Mister-Awsum/3D-Room-Scan/Project Info/20240410_174906.jpg

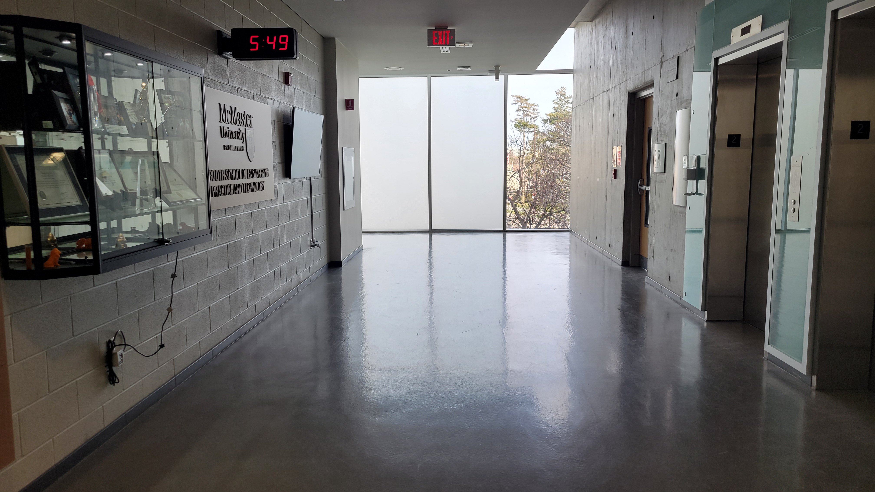
Project Info/20240410_174906.jpg
