Mister-Awsum/3D-Room-Scan/Data/2DX3 C Code Flowchart.png

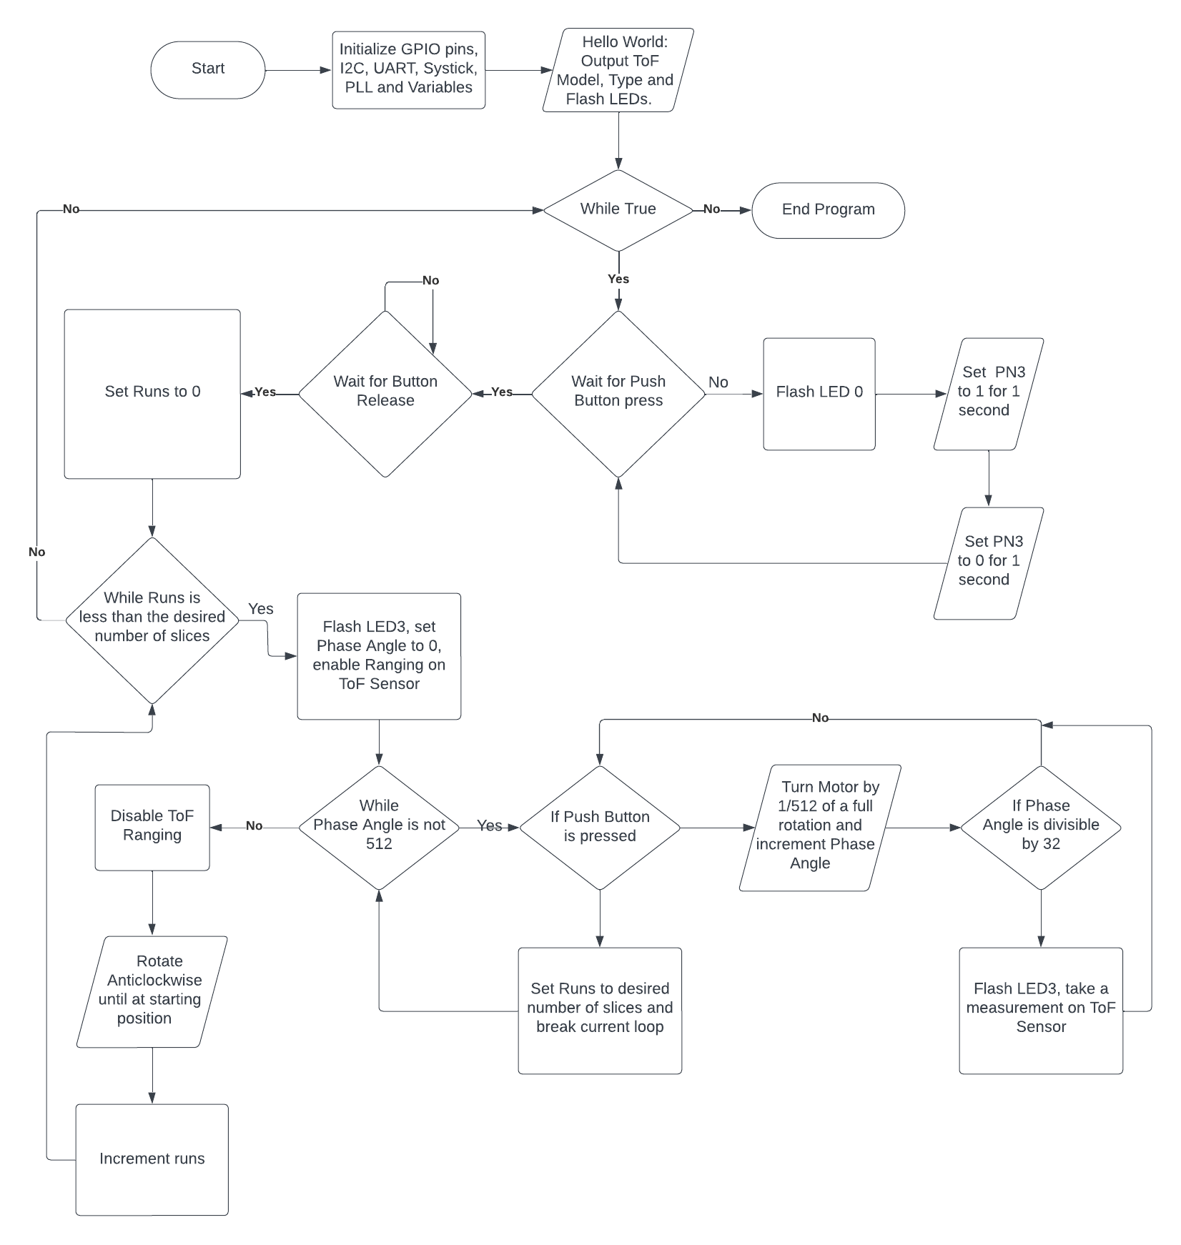
Data/2DX3 C Code Flowchart.png
