Mister-Awsum/3D-Room-Scan/Data/2DX3 Project Circuit Schematic.png

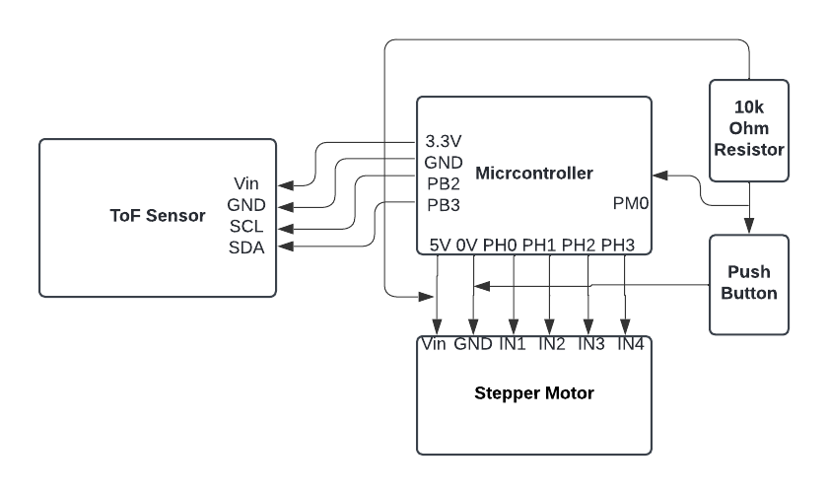
Data/2DX3 Project Circuit Schematic.png
