Mister-Awsum/3D-Room-Scan/Data/Also Scan.png

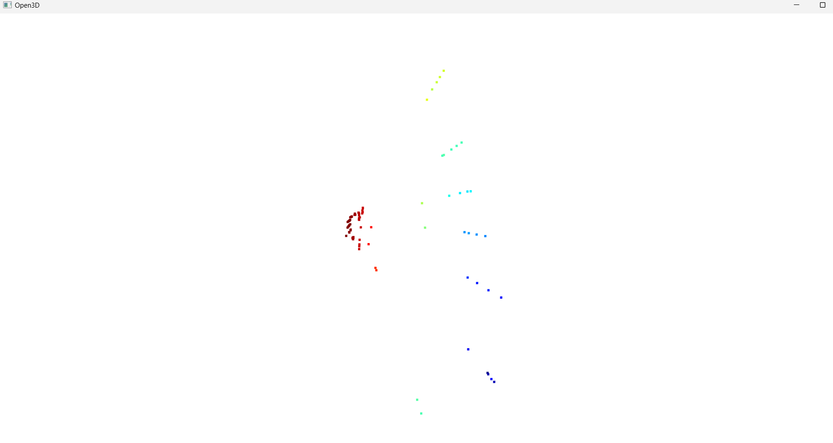
Data/Also Scan.png
