Mister-Awsum/3D-Room-Scan/Data/Scan.png

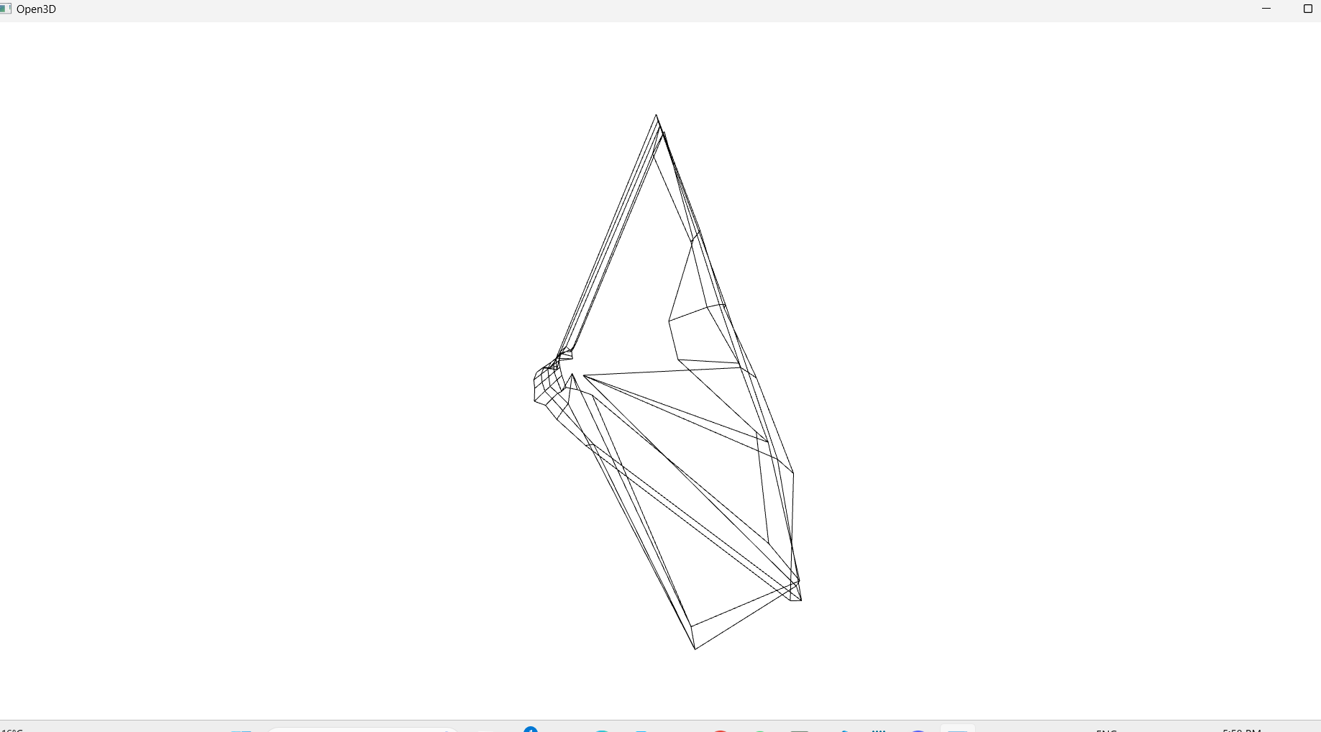
Data/Scan.png
