Mister-Awsum/3D-Room-Scan/patted9_ProjectDeliverable_2_Code/Circuit Scehmatic.asc

R1: res; 1k
S1: sw
Vcc: voltage; 5
Named nets: SCL/PB2, SDA/PB3, PM0, 0, PH0/IN1, PH1/IN2, PH2/IN3, PH3/IN4, Vcc, 3.3V
MICROCONTROLLER
Stepper Motor
ToF Sensor
